Miquel-Casals-Picornell/Industrial-Domotics-Projects/Home_Automation_KNX_Zelio/plànols i esquemas/Esquemes elèctrics.png

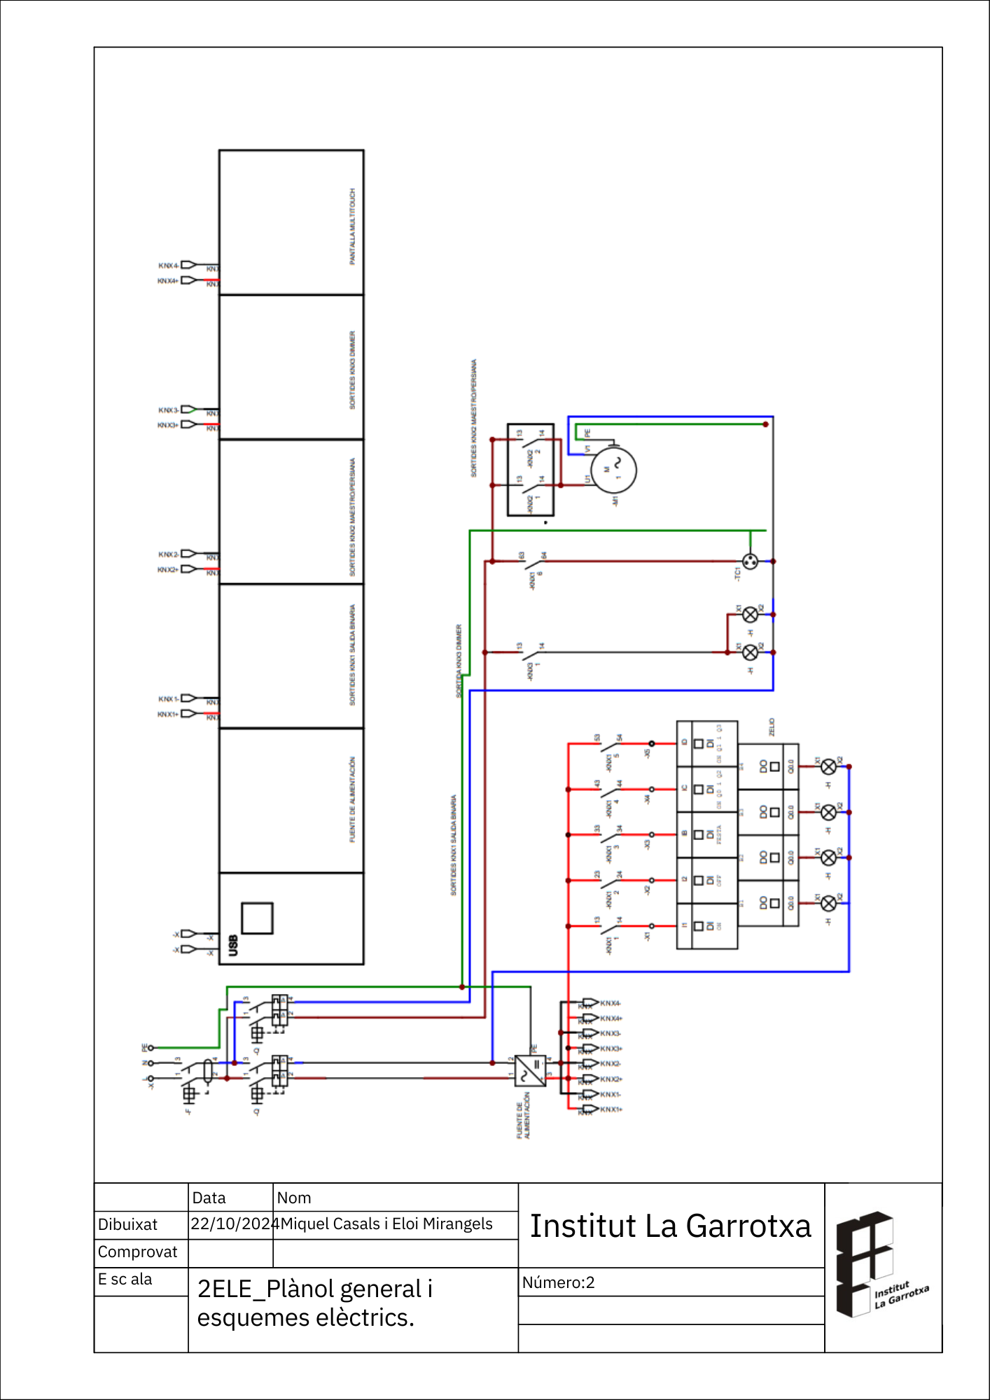
Home_Automation_KNX_Zelio/plànols i esquemas/Esquemes elèctrics.png
