Miquel-Casals-Picornell/Industrial-Domotics-Projects/(list of files, cad)

Other CAD files:
Home_Automation_KNX_Zelio/plànols i esquemas/Plànol autoCAD V2.dwg
