Miquel-Casals-Picornell/Industrial-Domotics-Projects/Home_Automation_KNX_Zelio/plànols i esquemas/Projecte 3 Plànol General.pdf

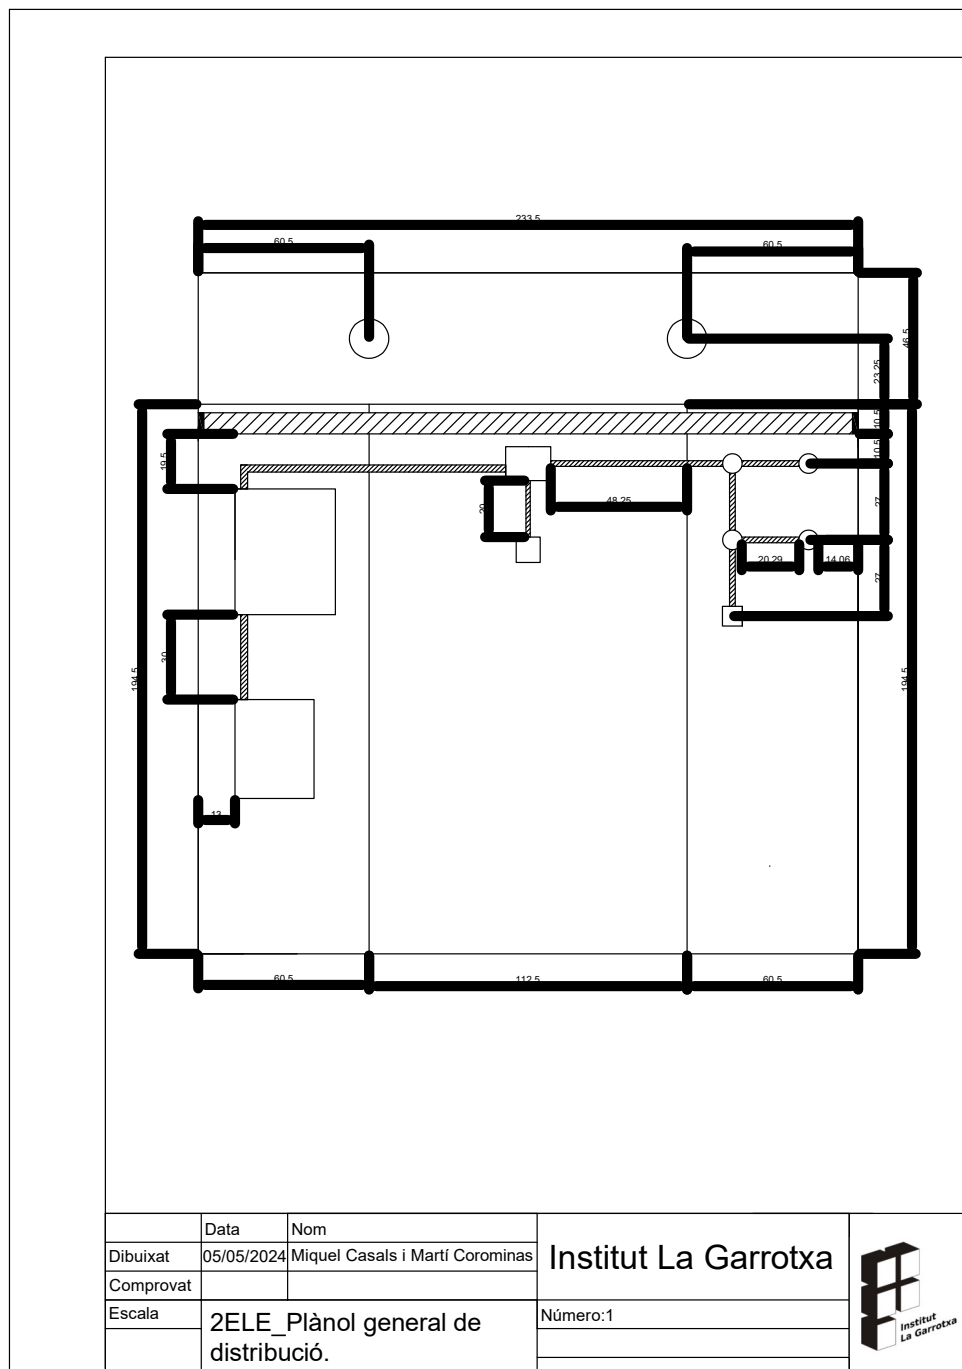
[picture p19: page 1]
60,5 ¹⁹⁴,5; Data; Nom; 2ELE_Plànol general de distribució.

Dibuixat | 05/05/2024 Miquel Casals i Martí Corominas Institut La Garrotxa

Comprovat
Escala | | Número:1
